mindThomas/STM32F0-MotorDriver/PCB/Rendering.png

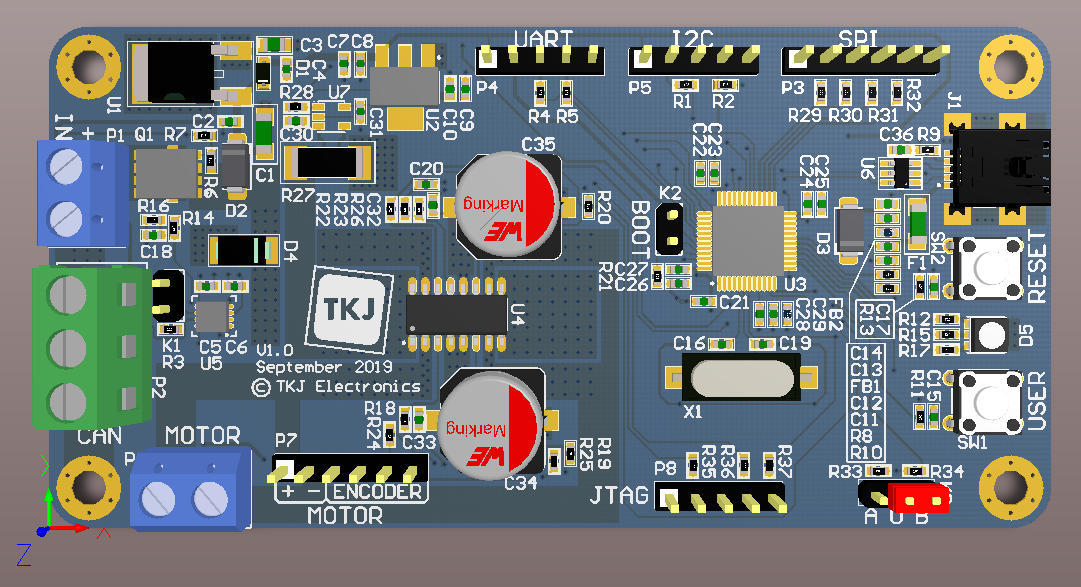
PCB/Rendering.png
