mindThomas/STM32F0-MotorDriver/README.md

# STM32F0-MotorDriver
Custom DC motor driver project (PCB+Firmware) with current control

## Cloning
Clone the repository recursively to download the included STM32 libraries
