mindThomas/STM32F0-MotorDriver/STM32 pinout overview.xlsx

STM32 pinout overview
Notes:
STM32F042C6T6
8 MHz HSE Oscillator
Device | Pin name | Pintype | I/O (set fra STM32) | Periphiral type | Assigned periphiral | STM32 Pin | Note | Extra Notes
Misc:
 | BTN | Digital | I | GPIO |  | PA4 | Active high, with debounce LPF
 | MASTER | Digital | I | GPIO |  | PB4 | Active high
 | SLAVE | Digital | I | GPIO |  | PB5 | Active high
LED:
 | Red | Digital | O | PWM | TIM3_CH3 | PB0 | 16-bit timer
 | Green | Digital | O | PWM | TIM3_CH2 | PA7 | 16-bit timer
 | Blue | Digital | O | PWM | TIM3_CH1 | PA6 | 16-bit timer
USB:
 | USB_DP | Digital | I/O | USB | USB_DP | PA12
 | USB_DM | Digital | I/O | USB | USB_DM | PA11
CAN:
 | CAN RX | Digital | I | CAN | CAN_RX | PB8
 | CAN TX | Digital | O | CAN | CAN_TX | PB9
 | CAN_STBY | Digital | O | GPIO |  | PA5
I2C:
 | SCL | Digital | I/O | I2C | I2C1_SCL | PB10
 | SDA | Digital | I/O | I2C | I2C1_SDA | PB11
UART:
 | TX | Digital | O | UART | USART1_TX | PB6
 | RX | Digital | I | UART | USART1_RX | PB7
SPI:
 | SCLK | Digital | O | SPI | SPI2_SCK | PB13
 | MISO | Digital | I | SPI | SPI2_MISO | PB14
 | MOSI | Digital | O | SPI | SPI2_MOSI | PB15
 | CS | Digital | O | SPI | SPI2_NSS | PB12
JTAG:
 | SWCLK | Digital | I | JTAG |  | PA14
 | SWDIO | Digital | I/O | JTAG |  | PA13
 | NRST | Digital | I | JTAG
Motor driver:
 | PWM | Digital | O | GPIO | TIM1_CH1 | PA8 | 16-bit timer
 | INA | Digital | O | GPIO | TIM1_CH2 | PA9 | 16-bit timer
 | INB | Digital | O | PWM | TIM1_CH3 | PA10 | 16-bit timer
 | SEL0 | Digital | O | GPIO |  | PA3 | Current sense selection according to Table 11. For current sense during operation pin should be set to the value as INA.
Encoder:
 | Encoder A | Digital | I | Quadrature Decoder | TIM2_CH1 | PA15 | 32-bit timer
 | Encoder B | Digital | I | Quadrature Decoder | TIM2_CH2 | PB3 | 32-bit timer
Sense:
 | CS | Analog | I | ADC | ADC_IN0 | PA0 | INA180 current sense | RC filter on INA Current Sense output of 10 KHz LPF
 | VNH_CS | Analog | I | ADC | ADC_IN1 | PA1 | VNH7070 high-side current sense output through a 681R sense resistor to ground | RC filter on VNH Current Sense output of 10 KHz LPF
 | VBAT | Analog | I | ADC | ADC_IN2 | PA2 | Voltage divider from VIN with 18.2 kOhm and 2.21 kOhm to ground | RC filter on VBAT measurement of 50-500 Hz LPF
 | VBUS_SENSE | Digital | I | GPIO | ADC_IN9 | PB1
