mindThomas/STM32F0-MotorDriver/Datasheets and Technical notes/TVS design recommendation (ESCON).png

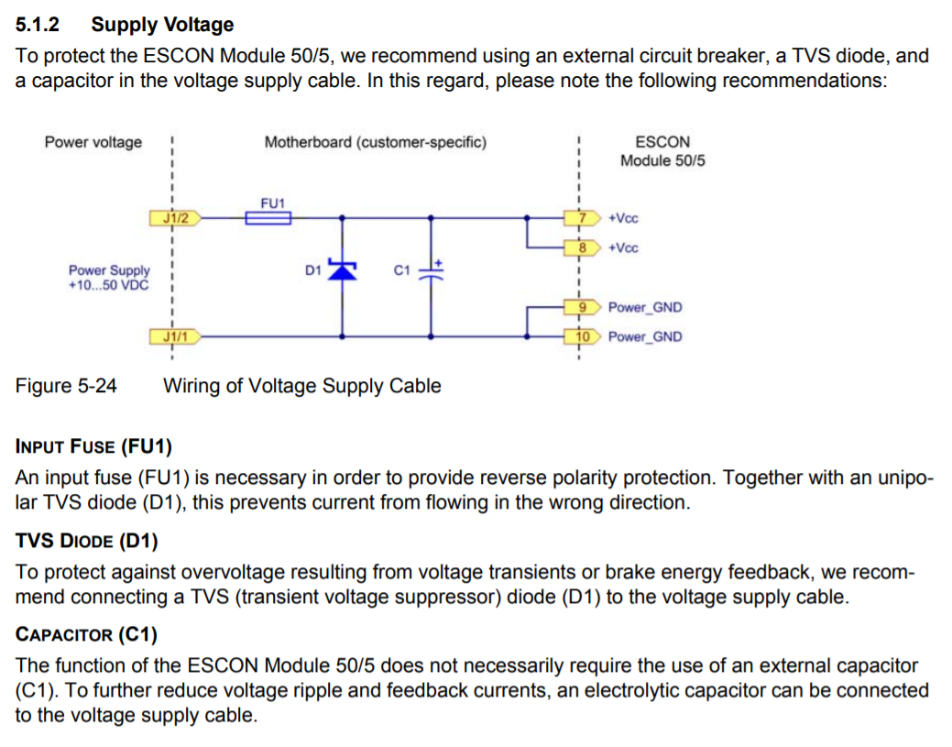
Datasheets and Technical notes/TVS design recommendation (ESCON).png
