mindThomas/STM32F0-MotorDriver/PCB/BOM_MotorDriverPCB_Detailed.xls

Sheet: BOM Report
Bill of Materials |  |  | <Parameter Title not found>
Source Data From: |  | MotorDriverPCB.PrjPCB
Project: |  | MotorDriverPCB.PrjPCB
Variant: |  | None
Creation Date: | 05-09-2019 | 00:21:36
Print Date: | 2019-09-16 | 23:00:03
Footprint | Comment | LibRef | Designator | Description |  | Manufacturer Part number | Digikey link | Quantity
1206C-GENERIC | 10uF, 50V | 1206C-10U-35V-X7R | C1 | GENERIC CAPACITOR NON POLARISED 1206 | Samsung Electro-Mechanics | CL31A106MBHNNNE | https://www.digikey.com/product-detail/en/samsung-electro-mechanics/CL31A106MBHNNNE/1276-6736-1-ND/5961595 | 1
0603C-GENERIC | 100nF | 0603C-100NF-25V-X7R-TDK | C2, C4, C5, C6, C8, C10, C13, C15, C17, C21, C22, C24, C26, C31, C32, C33, C36 | GENERIC CAPACITOR NON POLARISED 0603 | Samsung Electro-Mechanics | CL10B104KB8NNNC | https://www.digikey.com/product-detail/en/samsung-electro-mechanics/CL10B104KB8NNNC/1276-1000-1-ND/3889086 | 17
0805C-GENERIC | 10uF, 6.3V | 0805C-10UF-6V3-X5R-PAN | C3 | CAPACITOR 0805 CERAMIC | Samsung Electro-Mechanics | CL21A106KQCLRNC | https://www.digikey.com/product-detail/en/samsung-electro-mechanics/CL21A106KQCLRNC/1276-2405-1-ND/3890491 | 1
0603C-GENERIC | 1uF, 10V | 0603C-1UF-35V-X5R-TAY | C7, C9, C18, C29 | CAPACITOR 0603 CERAMIC | Samsung Electro-Mechanics | CL10A105MP8NNNC | https://www.digikey.com/product-detail/en/samsung-electro-mechanics/CL10A105MP8NNNC/1276-1866-1-ND/3889952 | 4
0603C-GENERIC | 4u7, 6.3V | 0603C-4U7-6V3-X5R-KEM | C11, C14, C23, C25, C27 | GENERIC CAPACITOR NON POLARISED 0603 | Samsung Electro-Mechanics | CL10A475KQ8NNNC | https://www.digikey.com/product-detail/en/samsung-electro-mechanics/CL10A475KQ8NNNC/1276-1045-1-ND/3889131 | 5
0603C-GENERIC | 10nF | 0603C-10NF-50V-X7R-MUR | C12, C20, C28, C30 | GENERIC CAPACITOR NON POLARISED 0603 | Walsin Technology Corporation | 0603B103K500CT | https://www.digikey.com/product-detail/en/walsin-technology-corporation/0603B103K500CT/1292-1386-1-ND/9355390 | 4
0603C-GENERIC | 18pF, NP0/COG 1% | 0603C-18PF-50V-C0G-MUR | C16, C19 | GENERIC CAPACITOR NON POLARISED 0603 | Walsin Technology Corporation | 0603N180J500CT | https://www.digikey.com/product-detail/en/walsin-technology-corporation/0603N180J500CT/1292-1494-1-ND/9355498 | 2
SMT_10x10.5 | 470uF, 35V | AluCap_SMT | C34, C35 | Surface mount, Polarized Electrolytic Aluminum Capacitor | Nichicon | UCL1V471MNL1GS | https://www.digikey.com/product-detail/en/nichicon/UCL1V471MNL1GS/493-3961-1-ND/2300388 | 2
SOD323 | DNP (NSR0530HT1G) | DIODE_SCHOTTKY | D1 | Diode Schottky | ON Semiconductor | NSR0530HT1G | https://www.digikey.com/product-detail/en/on-semiconductor/NSR0530HT1G/NSR0530HT1GOSCT-ND/5761654 | 1
DO-214AC-SMA | CDBA140-G | DIODE_SCHOTTKY | D2, D3 | Diode Schottky | Comchip Technology | CDBA140-G | https://www.digikey.com/product-detail/en/comchip-technology/CDBA140-G/641-1015-1-ND/1121137 | 2
DO-214AA | SMBJ26A | DIODE_TVS | D4 | Diode SMD Transil | Vishay Semiconductor Diodes Division | SMBJ26A-E3/52 | https://www.digikey.com/product-detail/en/vishay-semiconductor-diodes-division/SMBJ26A-E3-52/SMBJ26A-E3-52GICT-ND/2413391 | 1
LED-3535-6 | LED RGB Individual | LED RGB Individual | D5 | LED RGB Individual | Cree Inc. | CLX6F-FKC-CNP1ST1E1BB7D3D3 | https://www.digikey.com/product-detail/en/cree-inc/CLX6F-FKC-CNP1ST1E1BB7D3D3/CLX6F-FKC-CNP1ST1E1BB7D3D3CT-ND/6362814 | 1
1206C-GENERIC | 0ZCJ0035FF2G | FUSE-PTC | F1 | PTC Resettable Fuse | Bel Fuse Inc. | 0ZCJ0035FF2G | https://www.digikey.com/product-detail/en/bel-fuse-inc/0ZCJ0035FF2G/507-1800-1-ND/4156232 | 1
0603FB-GENERIC | BK1608TS102 | 0603FB-GENERIC | FB1, FB2 | FERRITE BEAD SMD | Taiyo Yuden | BK1608TS102-T | https://www.digikey.com/product-detail/en/taiyo-yuden/BK1608TS102-T/587-1895-1-ND/1465365 | 2
USB-MINI-B | USB Type B | USB-Type-B | J1 | Connector SMD-THD USB Type B middle mount | EDAC Inc. | 690-005-299-043 | https://www.digikey.com/product-detail/en/edac-inc/690-005-299-043/151-1206-1-ND/4312192 | 1
JMPR2 | JMPR2 | JMPR2 | K1, K2 | JMPR2 OPEN BY DEFAULT |  |  |  | 2
JMPR3-CLOSED-23 | JMPR3-23 | JMPR3-23 | K3 | JMPR3 |  |  |  | 1
SCREW-2-5mm | TB002-500-02BE | SCREW-2 | P1, P6 | Screw terminal, 2-pin, 5mm pitch | CUI Inc. | TB002-500-02BE | https://www.digikey.com/product-detail/en/cui-inc/TB002-500-02BE/102-6145-ND/10064069 | 2
SCREW-3-5mm | VI0301550000G | SCREW-3 | P2 | Screw terminal, 3-pin, 5mm pitch | Amphenol Anytek | VI0301550000G | https://www.digikey.com/product-detail/en/amphenol-anytek/VI0301550000G/609-3928-ND/2261293 | 1
HEADER-1X6 | Header 6 | Header 6 | P3, P7 | Header, 6-Pin |  |  |  | 2
HEADER-1X5 | UART1 | Header 5 | P4 | Header, 5-Pin |  |  |  | 1
HEADER-1X5 | I2C1 | Header 5 | P5 | Header, 5-Pin |  |  |  | 1
HEADER-1X5 | JTAG | Header 5 | P8 | Header, 5-Pin |  |  |  | 1
SO8FL-DFN5x6 | AONS21321 | MOSFET-P | Q1 | P-Channel MOSFET | Alpha & Omega Semiconductor Inc. | AONS21321 | https://www.digikey.com/product-detail/en/alpha-omega-semiconductor-inc/AONS21321/785-1800-1-ND/9974824 | 1
0603R-4K7 | 4K7 | 0603R-4K7 | R1, R2, R7, R8 | GENERIC RESISTOR 0603 | Stackpole Electronics Inc | RMCF0603FT4K70 | https://www.digikey.com/product-detail/en/stackpole-electronics-inc/RMCF0603FT4K70/RMCF0603FT4K70CT-ND/1943033 | 4
0603R-120 | 120R | 0603R-120 | R3 | GENERIC RESISTOR 0603 | Stackpole Electronics Inc | RMCF0603FT120R | https://www.digikey.com/product-detail/en/stackpole-electronics-inc/RMCF0603FT120R/RMCF0603FT120RCT-ND/1942967 | 1
0603R-1k | 1K | 0603R-1K | R4, R5, R18, R19, R20, R22, R24, R25, R29, R30, R31, R32 | GENERIC RESISTOR 0603 | Stackpole Electronics Inc | RMCF0603FT1K00 | https://www.digikey.com/product-detail/en/stackpole-electronics-inc/RMCF0603FT1K00/RMCF0603FT1K00CT-ND/1942996 | 12
0603R-10K | 10K | 0603R-10K | R6, R10, R11, R13, R21, R23, R28, R33, R34 | GENERIC RESISTOR 0603 | Stackpole Electronics Inc | RMCF0603FT10K0 | https://www.digikey.com/product-detail/en/stackpole-electronics-inc/RMCF0603FT10K0/RMCF0603FT10K0CT-ND/1943057 | 9
0603R-100K | 100K | 0603R-100K | R9 | GENERIC RESISTOR 0603 | Stackpole Electronics Inc | RMCF0603FT100K | https://www.digikey.com/product-detail/en/stackpole-electronics-inc/RMCF0603FT100K/RMCF0603FT100KCT-ND/1943118 | 1
0603R-82 | 82R | 0603R-82R | R12 | GENERIC RESISTOR 0603 | Stackpole Electronics Inc | RMCF0603FT82R0 | https://www.digikey.com/product-detail/en/stackpole-electronics-inc/RMCF0603FT82R0/RMCF0603FT82R0CT-ND/5049769 | 1
0603R-18K | 18.2K (1%) | 0603R-18K | R14 | GENERIC RESISTOR 0603 | Stackpole Electronics Inc | RMCF0603FT18K2 | https://www.digikey.com/product-detail/en/stackpole-electronics-inc/RMCF0603FT18K2/RMCF0603FT18K2CT-ND/1943073 | 1
0603R-56 | 56R | 0603R-56R | R15 | GENERIC RESISTOR 0603 | Stackpole Electronics Inc | RMCF0603FT56R0 | https://www.digikey.com/product-detail/en/stackpole-electronics-inc/RMCF0603FT56R0/RMCF0603FT56R0CT-ND/6053166 | 1
0603R-2K2 | 2.21K (1%) | 0603R-2K2 | R16 | GENERIC RESISTOR 0603 | Stackpole Electronics Inc | RMCF0603FT2K21 | https://www.digikey.com/product-detail/en/stackpole-electronics-inc/RMCF0603FT2K21/RMCF0603FT2K21CT-ND/1943012 | 1
0603R-27 | 27R | 0603R-27R | R17 | GENERIC RESISTOR 0603 | Stackpole Electronics Inc | RMCF0603FT27R0 | https://www.digikey.com/product-detail/en/stackpole-electronics-inc/RMCF0603FT27R0/RMCF0603FT27R0CT-ND/2418003 | 1
0603R-680 | 680R, 1% | 0603R-680 | R26 | GENERIC RESISTOR 0603 | Stackpole Electronics Inc | RMCF0603FT680R | https://www.digikey.com/product-detail/en/stackpole-electronics-inc/RMCF0603FT680R/RMCF0603FT680RCT-ND/6053170 | 1
2512R-GENERIC | 8 mOhm, 1%, 1W | 2512R | R27 | POWER RESISTOR 2512 | Panasonic Electronic Components | ERJ-M1WSF8M0U | https://www.digikey.com/product-detail/en/panasonic-electronic-components/ERJ-M1WSF8M0U/P8.0MCT-ND/300472 | 1
0603R-33 | 33R | 0603R-33 | R35, R36, R37 | GENERIC RESISTOR 0603 | Stackpole Electronics Inc | RMCF0603FT33R0 | https://www.digikey.com/product-detail/en/stackpole-electronics-inc/RMCF0603FT33R0/RMCF0603FT33R0CT-ND/1942950 | 3
TACT-TH-6x6 | 6X6_TACTILE | Tactile Switch | SW1, SW2 | Tactile Switch | TE Connectivity | 1825910-6 | https://www.digikey.com/product-detail/en/te-connectivity-alcoswitch-switches/1825910-6/450-1650-ND/1632536 | 2
DPAK | MC78M05CDTRKG | MC78M05CDTRKG | U1 | 5V, 500mA, LDO Regulator, 3-Pin DDPAK | ON Semiconductor | MC78M05CDTRKG | https://www.digikey.com/product-detail/en/on-semiconductor/MC78M05CDTRKG/MC78M05CDTRKGOSCT-ND/1139757 | 1
SOT-223 | AZ1117EH-3.3TRG1 | AZ1117EH-3.3TRG1 | U2 | 3.3V, 1A, LDO Regulator, 3-Pin SOT-223 | Diodes Incorporated | AZ1117EH-3.3TRG1 | https://www.digikey.com/product-detail/en/diodes-incorporated/AZ1117EH-3.3TRG1/AZ1117EH-3.3TRG1DICT-ND/5001336 | 1
STM-LQFP48_N | STM32F042C6T6 | STM32F042C6T6 | U3 | IC MCU 32BIT 32KB FLASH 48LQFP | STMicroelectronics | STM32F042C6T6TR | https://www.digikey.com/product-detail/en/stmicroelectronics/STM32F042C6T6TR/497-19319-1-ND/10063344 | 1
STM-SO-16N_M | VNH7070ASTR | VNH7070ASTR | U4 | SO 16 .15 TO JEDEC MS-012 | STMicroelectronics | VNH7070ASTR | https://www.digikey.com/product-detail/en/stmicroelectronics/VNH7070ASTR/497-17630-1-ND/7691023 | 1
VDFN8 | ATA6561 | ATA6561 | U5 | High-Speed CAN Transceiver with Standby Mode CAN FD Ready | Microchip Technology | ATA6561-GBQW-N | https://www.digikey.com/product-detail/en/microchip-technology/ATA6561-GBQW-N/ATA6561-GBQW-NCT-ND/9453176 | 1
SOT23-6 | USBLC6 | USBLC6 | U6 | Very low capacitance ESD protection | STMicroelectronics | USBLC6-2SC6 | https://www.digikey.com/product-detail/en/stmicroelectronics/USBLC6-2SC6/497-5235-1-ND/1121688 | 1
SOT23-5 | INA180A2 (50 V/V) | INA180A | U7 | INAx180 Low- and high-side voltage output, current-sense amplifiers | Texas Instruments | INA180A2IDBVT | https://www.digikey.com/product-detail/en/texas-instruments/INA180A2IDBVT/296-46628-1-ND/7219064 | 1
HC-49/US | 8MHz HC-49/US | HC-49/US | X1 | HC-49/US 8MHz, 18 pF, 30 ppm | Abracon LLC | ABLS-8.000MHZ-B-4-Y-T | https://www.digikey.com/product-detail/en/abracon-llc/ABLS-8.000MHZ-B-4-Y-T/535-14946-1-ND/9998023 | 1
 |  |  |  |  |  |  |  | 104
Approved |  | Notes

Sheet: Project Information
Project Full Path | C:\Users\Thomas\Dropbox\DC motor driver project\MotorDriverPCB.PrjPCB
Project Filename | MotorDriverPCB.PrjPCB
Variant Name | None
Data-Source Filename | MotorDriverPCB.PrjPCB
Data-Source Full Path | C:\Users\Thomas\Dropbox\DC motor driver project\MotorDriverPCB.PrjPCB
Title | <Parameter Title not found>
Total Quantity | 108
Report Time | 00:21:36
Report Date | 05-09-2019
Report Date & Tine | 05-09-2019 00:21:36
Output Name | Bill of Materials
Output Type | BOM_PartType
Output Generator Name | BOM
Output Generator Description | Bill of Materials
