mindThomas/STM32F0-MotorDriver/PCB/Schematic V1.0.pdf

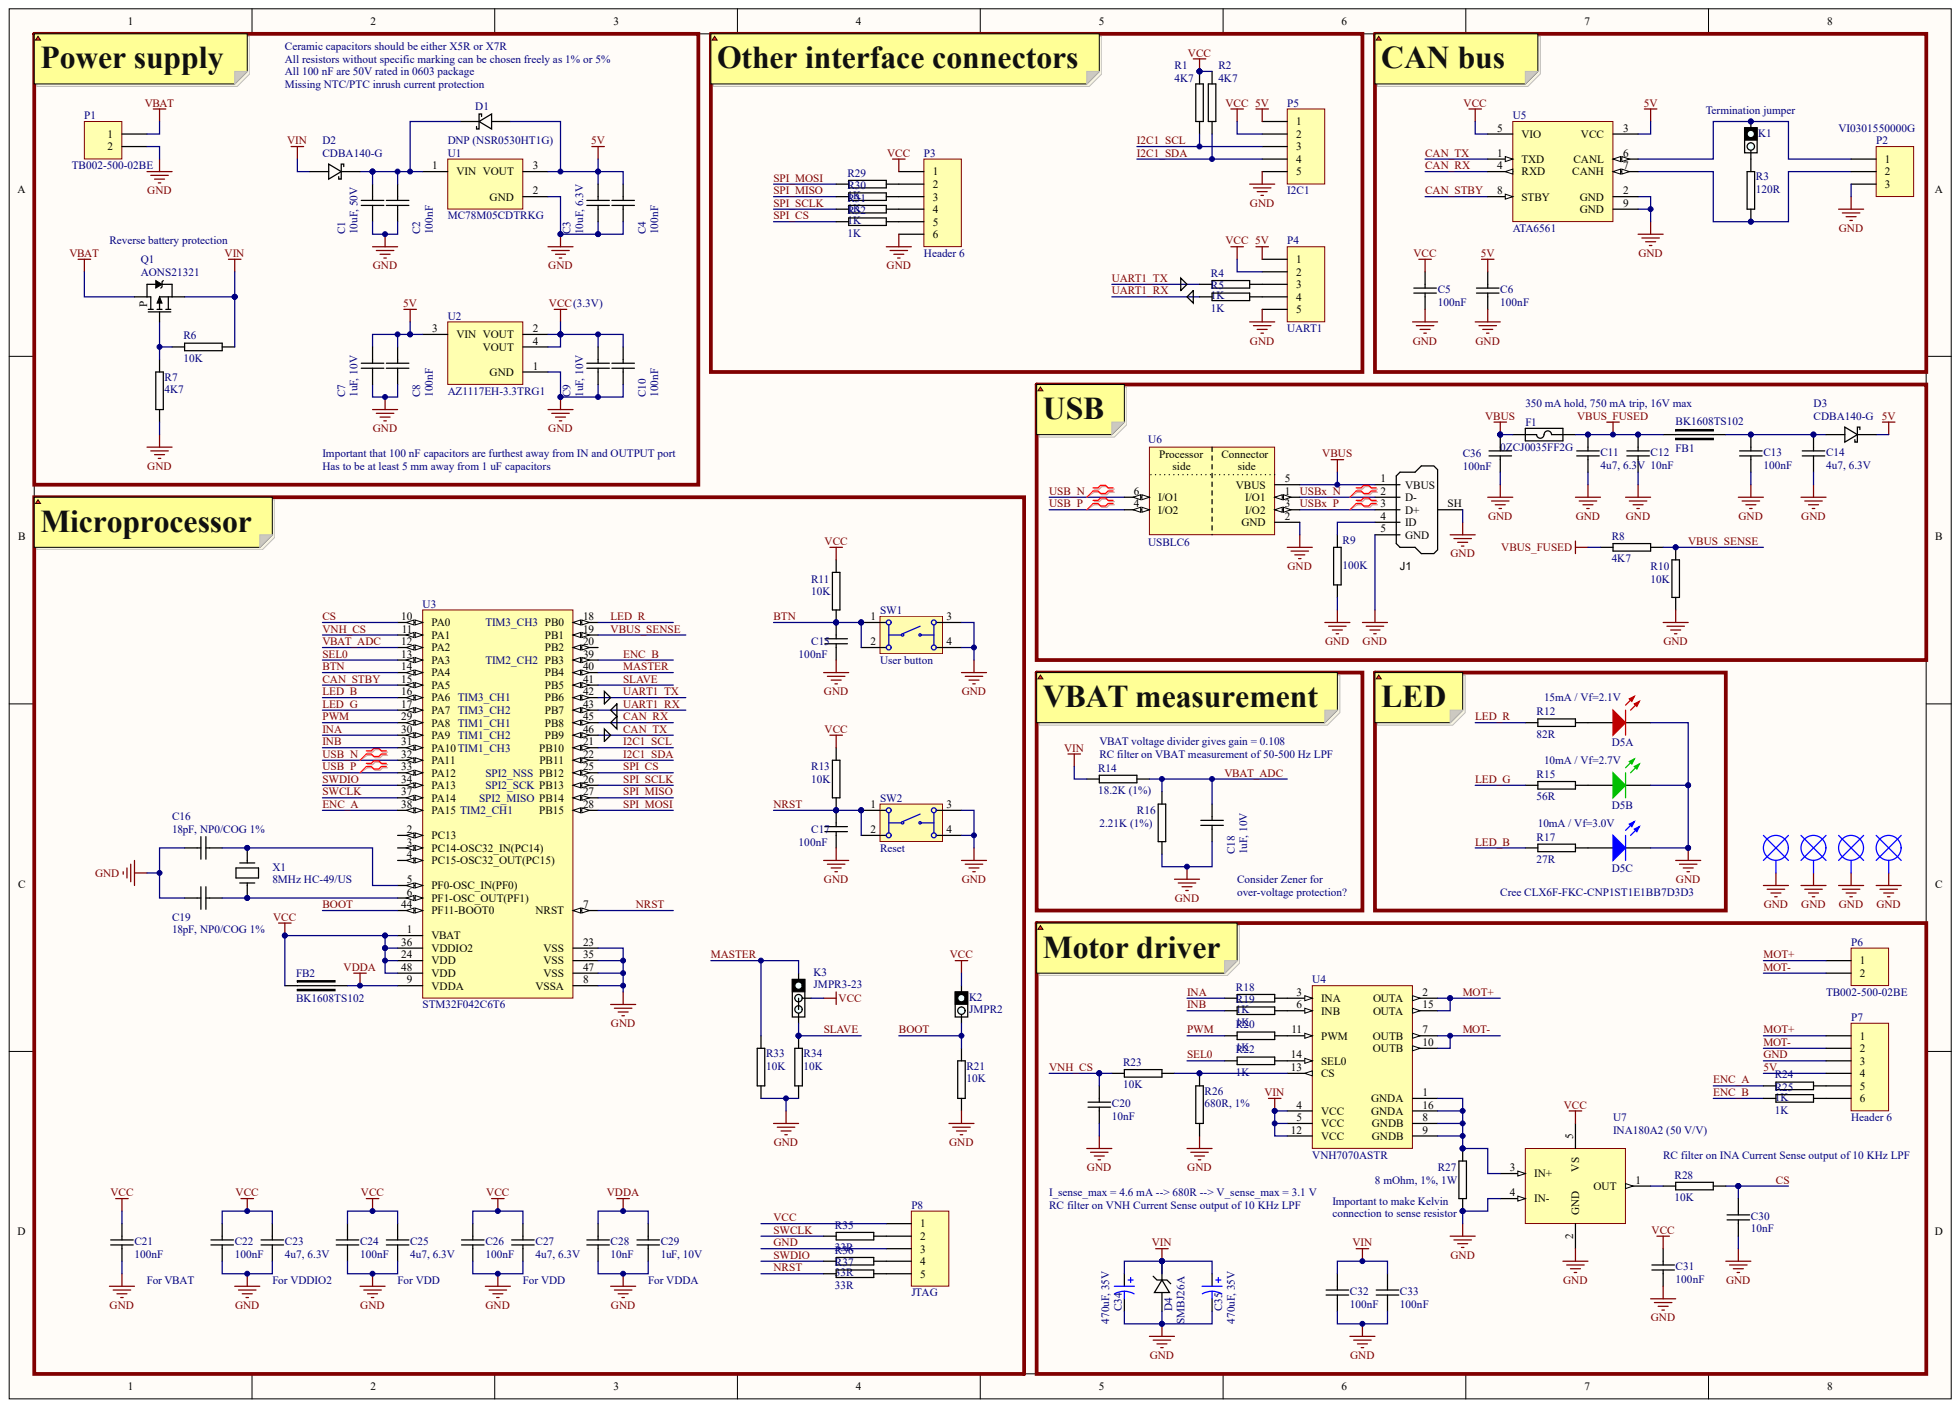
[picture p3: page 1]

Ceramic capacitors should be either X5R or X7R
All resistors without specific marking can be chosen freely as 1% or 5%
All 100 nF are 50V rated in 0603 package
Missing NTC/PTC inrush current protection

Important that 100 nF capacitors are furthest away from IN and OUTPUT port
Has to be at least 5 mm away from 1 uF capacitors

Processor side | Connector side

VBAT voltage divider gives gain = 0.108
RC filter on VBAT measurement of 50-500 Hz LPF

RC filter on INA Current Sense output of 10 KHz LPF

I_sense_max = 4.6 mA --> 680R --> V_sense_max = 3.1 V
RC filter on VNH Current Sense output of 10 KHz LPF

Important to make Kelvin
connection to sense resistor

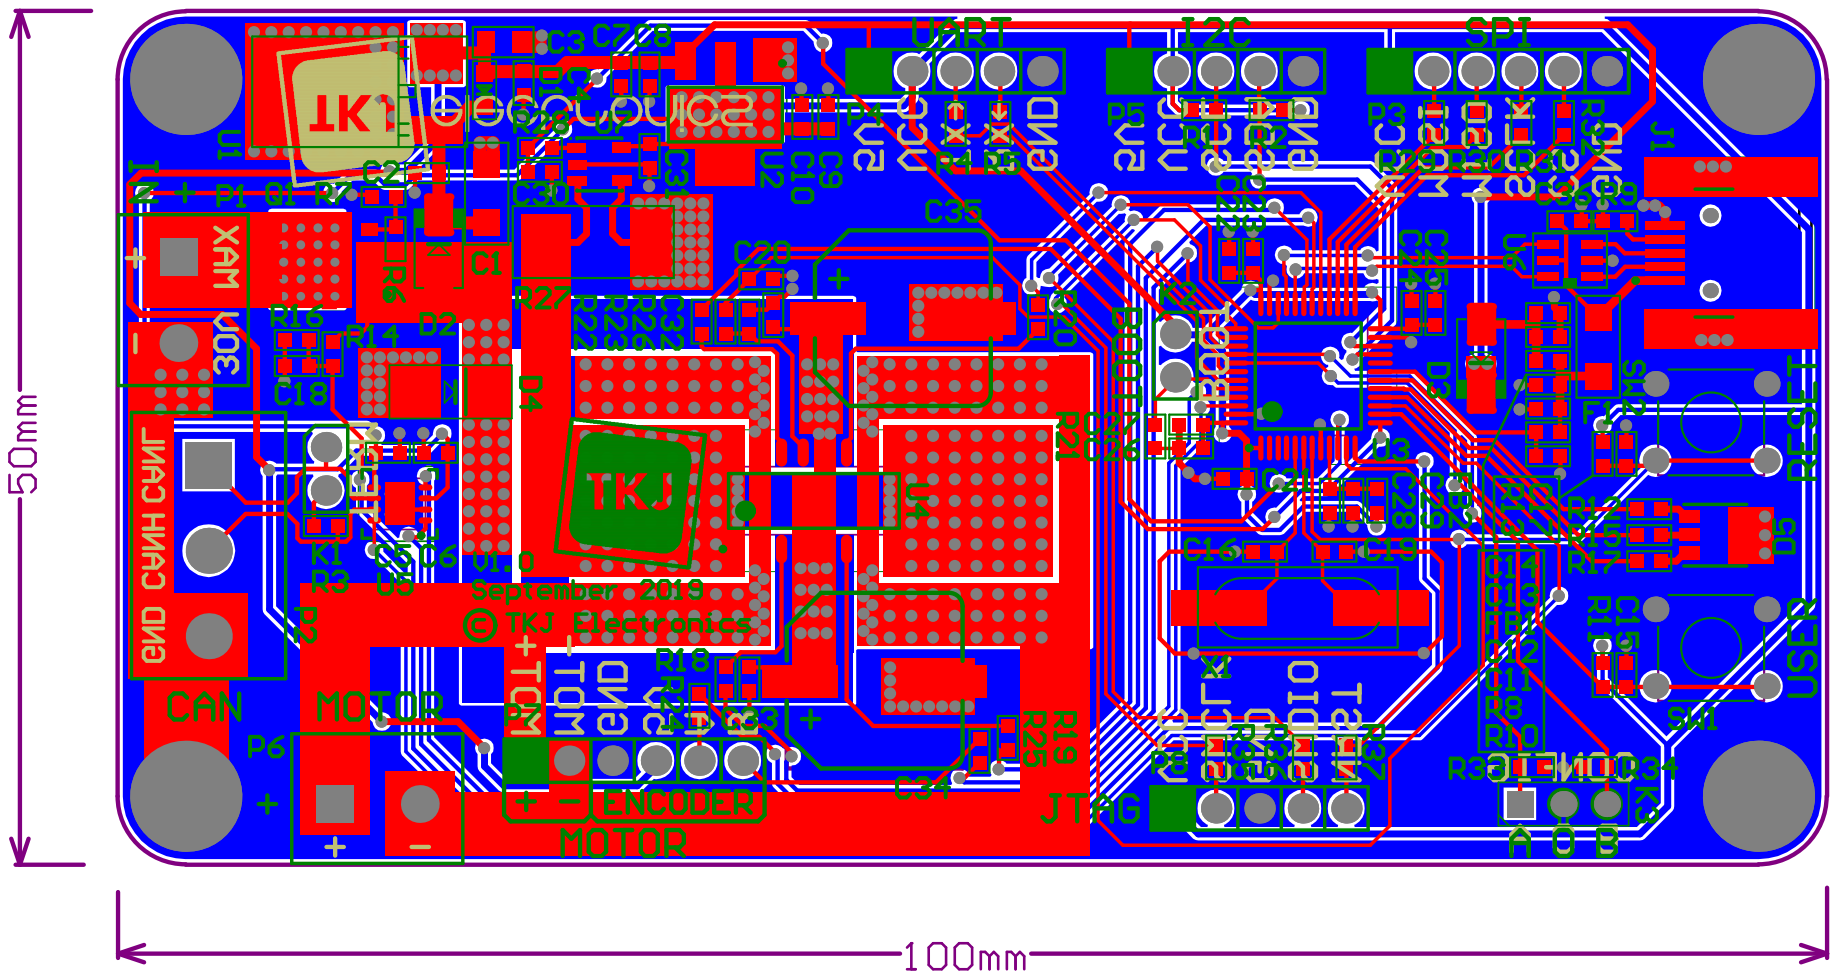
[picture p4: page 2]
