mindThomas/STM32F0-MotorDriver/(list of files, drawings)

Other design files:
PCB/Altium/Components.PcbLib
PCB/Altium/Components.SchLib
PCB/Altium/MotorDriverPCB.PcbDoc
PCB/Altium/MotorDriverPCB.PrjPCB
PCB/Altium/MotorDriverPCB.SchDoc
