mindThomas/STM32F0-MotorDriver/Firmware/MotorDriver-Firmware.ioc

Mcu.UserName=STM32F042C6Tx
PA0.Signal=ADC_IN0
PA1.Signal=ADC_IN1
PA10.Signal=S_TIM1_CH3
PA13.Signal=SYS_SWDIO
PA14.Signal=SYS_SWCLK
PA15.Signal=S_TIM2_CH1_ETR
PA2.Signal=ADC_IN2
PA3.Signal=GPIO_Output
PA4.Signal=GPIO_Output
PA5.Signal=GPIO_Output
PA6.Signal=S_TIM3_CH1
PA7.Signal=S_TIM3_CH2
PA8.Signal=S_TIM1_CH1
PA9.Signal=S_TIM1_CH2
PB0.Signal=S_TIM3_CH3
PB1.Signal=ADC_IN9
PB10.Signal=I2C1_SCL
PB11.Signal=I2C1_SDA
PB12.Signal=SPI2_NSS
PB13.Signal=SPI2_SCK
PB14.Signal=SPI2_MISO
PB15.Signal=SPI2_MOSI
PB3.Signal=S_TIM2_CH2
PB4.Signal=GPIO_Input
PB5.Signal=GPIO_Input
PB6.Signal=USART1_TX
PB7.Signal=USART1_RX
PF0-OSC_IN.Signal=RCC_OSC_IN
PF1-OSC_OUT.Signal=RCC_OSC_OUT
