mindThomas/STM32F0-MotorDriver/Firmware/Src/main.c

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

/* Includes ------------------------------------------------------------------*/
#include "main.h"

/* USER CODE BEGIN Includes */
#include "string.h" // for memset
/* USER CODE END Includes */


/* USER CODE BEGIN PV */
#define SAMPLE_COUNT 400
static _Bool recordSamples = 0;
static uint32_t time_low[SAMPLE_COUNT];
static uint32_t time_high[SAMPLE_COUNT];
//static uint32_t time_vin[2*SAMPLE_COUNT];
static int16_t sample_low[SAMPLE_COUNT];
static int16_t sample_high[SAMPLE_COUNT];
//static int16_t sample_vin[2*SAMPLE_COUNT];
static uint32_t sampleIndex_low = 0;
static uint32_t sampleIndex_high = 0;
//static uint32_t sampleIndex_vin = 0;

float vref = 0;
uint32_t vref_uint = 0;
const uint32_t VREF_SAMPLE_COUNT_FINISHED = 1000;
uint32_t vrefSampleCount = 10000;
uint16_t VrefVoltage = 0;
int32_t ADC_offset = 0;

_Bool ChannelAlternation = 0;
_Bool FirstTime = 1;
_Bool PWM_Level = 1;
uint16_t Duty1preload = 0, Duty2preload = 0;
uint16_t Duty1 = 0, Duty2 = 0;
/* USER CODE END PV */

void SystemClock_Config(void);
static void MX_GPIO_Init(void);
static void MX_I2C1_Init(void);
static void MX_USART1_UART_Init(void);
static void MX_SPI2_Init(void);
static void MX_TIM1_Init(void);
static void MX_ADC_Init(void);
static void MX_TIM2_Init(void);
static void MX_TIM3_Init(void);
/* USER CODE BEGIN PFP */
void SetTimerFrequencyAndDutyCycle(uint32_t freq, float dutyPct);
void BufferTransfer(uint8_t * buffer, uint16_t bytesToSend);
/* USER CODE END PFP */

/**
  * @brief  The application entry point.
  * @retval int
  */
int main(void)
{
  /* USER CODE BEGIN 1 */
  memset(time_low, 0, sizeof(time_low));
  memset(time_high, 0, sizeof(time_high));
  memset(sample_low, 0, sizeof(sample_low));
  memset(sample_high, 0, sizeof(sample_high));
  /* USER CODE END 1 */


  /* MCU Configuration--------------------------------------------------------*/

  /* Configure the system clock */
  SystemClock_Config();

  /* Reset of all peripherals, Initializes the Flash interface and the Systick. */
  HAL_Init();

  /* USER CODE BEGIN Init */
  LL_Init1msTick(48000000);   // enabling use of e.g. LL_SYSTICK_IsActiveCounterFlag()
  /* USER CODE END Init */

  /* Initialize all configured peripherals */
  MX_GPIO_Init();
  //MX_I2C1_Init();
  MX_USART1_UART_Init();
  MX_SPI2_Init();
  MX_TIM1_Init();
  MX_ADC_Init();
  MX_TIM2_Init();
  MX_TIM3_Init();
  /* USER CODE BEGIN 2 */

  // Initialize debug output pin
  LL_GPIO_InitTypeDef GPIO_InitStruct = {0};
  GPIO_InitStruct.Pin = LL_GPIO_PIN_10;
  GPIO_InitStruct.Mode = LL_GPIO_MODE_OUTPUT;
  GPIO_InitStruct.Speed = LL_GPIO_SPEED_FREQ_LOW;
  GPIO_InitStruct.OutputType = LL_GPIO_OUTPUT_PUSHPULL;
  GPIO_InitStruct.Pull = LL_GPIO_PULL_NO;
  LL_GPIO_Init(GPIOB, &GPIO_InitStruct);

  GPIOA->BSRR = GPIO_PIN_3; // SEL0 = High
  SetTimerFrequencyAndDutyCycle(1000, 0.5);
  LL_TIM_OC_SetCompareCH1(TIM1, 0); // PWM
  LL_TIM_OC_SetCompareCH2(TIM1, 0); // INA = High
  LL_TIM_OC_SetCompareCH3(TIM1, 0); // INB = Low

  // Enable all available PWM (output compare) outputs
  LL_TIM_EnableAllOutputs(TIM1);

  // Enable timer
  LL_TIM_EnableCounter(TIM1);

  // Enable channels
  LL_TIM_CC_EnableChannel(TIM1, LL_TIM_CHANNEL_CH1);
  LL_TIM_CC_EnableChannel(TIM1, LL_TIM_CHANNEL_CH2);
  LL_TIM_CC_EnableChannel(TIM1, LL_TIM_CHANNEL_CH3);
  LL_TIM_CC_EnableChannel(TIM1, LL_TIM_CHANNEL_CH4);

	HAL_Delay(2000); // wait for stabilization

	/*// Vref calibration: Take 1000 samples of Vref sampled at 1000 Hz
	vref_uint = 0;
	vrefSampleCount = 0; // sample offset
	while (vrefSampleCount < VREF_SAMPLE_COUNT_FINISHED)
		HAL_Delay(1);

	vref_uint = vref_uint / vrefSampleCount;
	vrefSampleCount = VREF_SAMPLE_COUNT_FINISHED + 1; // marks that offset computation has finished
	VrefVoltage = __LL_ADC_CALC_VREFANALOG_VOLTAGE(vref_uint, LL_ADC_RESOLUTION_12B);

	// Offset calibration: Take 1000 samples of VNH_CS sampled at 1000 Hz
	LL_ADC_REG_SetSequencerChannels(ADC1, LL_ADC_CHANNEL_1); // change to sample from channel 1 (VNH_CS)
	vref_uint = 0;
	vrefSampleCount = 0; // sample offset
	while (vrefSampleCount < VREF_SAMPLE_COUNT_FINISHED)
		HAL_Delay(1);

	vref_uint = vref_uint / vrefSampleCount;
	vrefSampleCount = VREF_SAMPLE_COUNT_FINISHED + 1; // marks that offset computation has finished
	ADC_offset = vref_uint;*/

	//LL_ADC_REG_SetSequencerChannels(ADC1, LL_ADC_CHANNEL_0); // change to sample from channel 0 (INA180_CS)
	LL_ADC_REG_SetSequencerChannels(ADC1, LL_ADC_CHANNEL_1); // change to sample from channel 1 (VNH_CS)
	HAL_Delay(1000); // wait for stabilization

	SetTimerFrequencyAndDutyCycle(20000, 0.5);

	/*recordSamples = 1;

	while (sampleIndex_low < SAMPLE_COUNT && sampleIndex_high < SAMPLE_COUNT)
		HAL_Delay(1);

	recordSamples = 0;*/

	recordSamples = 1;

  /* USER CODE END 2 */

  /* Infinite loop */
  /* USER CODE BEGIN WHILE */
  int8_t duty = 50;
  _Bool up = 1;
  while (1)
  {
    /* USER CODE END WHILE */
	  SetTimerFrequencyAndDutyCycle(20000, (float)duty / 100.0f);
	  HAL_Delay(30);
	  if (up)
		  duty += 1;
	  else
		  duty -= 1;

	  if (duty >= 100 || duty <= 0)
		  up = !up;
    /* USER CODE BEGIN 3 */
  }
  /* USER CODE END 3 */
}

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
/* USER CODE BEGIN 4 */
void SetTimerFrequencyAndDutyCycle(uint32_t freq, float dutyPct)
{
	const uint32_t PCLK = 48000000;
	const uint16_t PRESCALER = 23;
	const float ADC_SAMPLE_TIME_US = 4.5; // See MATLAB script: 'ADC_Configuration.m'
	const float HIGH_SAMPLE_OFFSET_US = 10;
	const float LOW_SAMPLE_OFFSET_US = 10;

	LL_TIM_SetPrescaler(TIM1, PRESCALER);

	uint32_t ARR = (PCLK / (uint32_t)(freq*(PRESCALER+1))) - 1;
	LL_TIM_SetAutoReload(TIM1, ARR);

	if (dutyPct < 0) dutyPct = 0.0;
	if (dutyPct > 1) dutyPct = 1.0;

	uint16_t END = ARR + 1;
	uint16_t CENTER = END * dutyPct;
	uint16_t HighOffsetDuty = (END*freq) / (1000000 / HIGH_SAMPLE_OFFSET_US);
	uint16_t LowOffsetDuty = (END*freq) / (1000000 / LOW_SAMPLE_OFFSET_US);
	uint16_t SampleTimeOffsetDuty = (END*freq) / (1000000 / ADC_SAMPLE_TIME_US);

	if (CENTER > (LOW_SAMPLE_OFFSET_US+SampleTimeOffsetDuty))
		Duty1preload = CENTER/2 - SampleTimeOffsetDuty;
	else
		Duty1preload = CENTER/2 + HIGH_SAMPLE_OFFSET_US;
	//Duty2preload = (END - CENTER) / 2 + CENTER - SampleDuty;
	//Duty1preload = CENTER - SampleDuty;
	//Duty2preload = END - SampleDuty;
	//Duty1preload = LowOffsetDuty;
	//Duty2preload = CENTER + HighOffsetDuty;

	LL_TIM_OC_SetCompareCH1(TIM1, CENTER); // PWM
	LL_TIM_OC_SetCompareCH2(TIM1, END); // INA = High
	LL_TIM_OC_SetCompareCH3(TIM1, 0); // INB = Low

	if (FirstTime) {
		Duty1 = Duty1preload;
		Duty2 = Duty2preload;
		LL_TIM_OC_SetCompareCH4(TIM1, Duty1); // Sample location
	}

	/*
    //__HAL_TIM_SET_COMPARE(&htim1, TIM_CHANNEL_5, CENTER - SampleDuty); // sample location
    //__HAL_TIM_SET_COMPARE(&htim1, TIM_CHANNEL_6, END - SampleDuty); // sample location
    __HAL_TIM_SET_COMPARE(&htim1, TIM_CHANNEL_5, CENTER/2 - SampleDuty); // sample location
    __HAL_TIM_SET_COMPARE(&htim1, TIM_CHANNEL_6, (END - CENTER) / 2 + CENTER - SampleDuty); // sample location

	__HAL_TIM_SET_COMPARE(&htim1, TIM_CHANNEL_1, 0);
	__HAL_TIM_SET_COMPARE(&htim1, TIM_CHANNEL_3, CENTER);
	*/
}

void BufferTransfer(uint8_t * buffer, uint16_t bytesToSend)
{
  uint16_t ubSend = 0;
  /* Send characters one per one, until last char to be sent */
  while (ubSend < bytesToSend)
  {
#if (USE_TIMEOUT == 1)
    Timeout = USART_SEND_TIMEOUT_TXE_MS;
#endif /* USE_TIMEOUT */

    /* Wait for TXE flag to be raised */
    while (!LL_USART_IsActiveFlag_TXE(USART1))
    {
#if (USE_TIMEOUT == 1)
      /* Check Systick counter flag to decrement the time-out value */
      if (LL_SYSTICK_IsActiveCounterFlag())
      {
        if(Timeout-- == 0)
        {
          /* Time-out occurred. Set LED to blinking mode */
          //LED_Blinking(LED_BLINK_SLOW);
        }
      }
#endif /* USE_TIMEOUT */
    }

    /* If last char to be sent, clear TC flag */
    if (ubSend == (bytesToSend - 1))
    {
      LL_USART_ClearFlag_TC(USART1);
    }

    /* Write character in Transmit Data register.
       TXE flag is cleared by writing data in TDR register */
    LL_USART_TransmitData8(USART1, buffer[ubSend++]);
  }

#if (USE_TIMEOUT == 1)
  Timeout = USART_SEND_TIMEOUT_TC_MS;
#endif /* USE_TIMEOUT */

  /* Wait for TC flag to be raised for last char */
  while (!LL_USART_IsActiveFlag_TC(USART1))
  {
#if (USE_TIMEOUT == 1)
    /* Check Systick counter flag to decrement the time-out value */
    if (LL_SYSTICK_IsActiveCounterFlag())
    {
      if(Timeout-- == 0)
      {
        /* Time-out occurred. Set LED to blinking mode */
        //LED_Blinking(LED_BLINK_SLOW);
      }
    }
#endif /* USE_TIMEOUT */
  }
}

void TIM1_BRK_UP_TRG_COM_IRQHandler(void)
{
  /* Check whether CC1 interrupt is pending */
  if(LL_TIM_IsActiveFlag_TRIG(TIM1) == 1)
  {
    /* Clear the update interrupt flag*/
    LL_TIM_ClearFlag_TRIG(TIM1);

    // Toggle debug pin
    GPIOB->ODR ^= GPIO_PIN_10;
  }
}

uint32_t _frequency = 100;
void ADC1_IRQHandler(void)
{
  /* Check whether ADC group regular end of unitary conversion caused         */
  /* the ADC interruption.                                                    */
  if(LL_ADC_IsActiveFlag_EOC(ADC1) != 0)
  {
    /* Clear flag ADC group regular end of unitary conversion */
    LL_ADC_ClearFlag_EOC(ADC1);

    // Toggle debug pin
    GPIOB->ODR ^= GPIO_PIN_10;

    if (vrefSampleCount < VREF_SAMPLE_COUNT_FINISHED) {
		vref_uint += LL_ADC_REG_ReadConversionData12(ADC1);
		vrefSampleCount++;
	}
	if (recordSamples) {
		int32_t sample = (int32_t)LL_ADC_REG_ReadConversionData12(ADC1) - ADC_offset;
		if (PWM_Level == 1) { // sampling at the transition from Low to High == Low value sampling
			if (sampleIndex_low < SAMPLE_COUNT) {
				time_low[sampleIndex_low] = HAL_GetHighResTick();
				sample_low[sampleIndex_low] = sample;
				sampleIndex_low++;
			}
		} else {
			if (sampleIndex_high < SAMPLE_COUNT) {
				time_high[sampleIndex_high] = HAL_GetHighResTick();
				sample_high[sampleIndex_high] = sample;
				sampleIndex_high++;
			}
		}
	}

#if 0
    // Update Duty cycle to enable sampling on both low-to-high and high-to-low edge
    if (PWM_Level) {
    	LL_TIM_OC_SetCompareCH4(TIM1, Duty2);
    } else {
    	/*if (recordSamples) {
    		SetTimerFrequencyAndDutyCycle(_frequency, 0.5);
			_frequency += 5;
    	}*/

    	/*
    	if (ChannelAlternation == 0)
    			LL_ADC_REG_SetSequencerChannels(ADC1, LL_ADC_CHANNEL_1);
    		else
    			LL_ADC_REG_SetSequencerChannels(ADC1, LL_ADC_CHANNEL_0);
    		ChannelAlternation = !ChannelAlternation;
    	}
    	*/

    	Duty1 = Duty1preload;
    	Duty2 = Duty2preload;
    	LL_TIM_OC_SetCompareCH4(TIM1, Duty1);
    }
    PWM_Level = !PWM_Level;
#endif
  }
}
/* USER CODE END 4 */

/**
  * @brief  Period elapsed callback in non blocking mode
  * @note   This function is called  when TIM16 interrupt took place, inside
  * HAL_TIM_IRQHandler(). It makes a direct call to HAL_IncTick() to increment
  * a global variable "uwTick" used as application time base.
  * @param  htim : TIM handle
  * @retval None
  */
void HAL_TIM_PeriodElapsedCallback(TIM_HandleTypeDef *htim)
{
  if (htim->Instance == TIM16) {
    HAL_IncTick();
  }
}

/**
  * @brief  This function is executed in case of error occurrence.
  * @retval None
  */
void Error_Handler(void)
{
  /* USER CODE BEGIN Error_Handler_Debug */
  /* User can add his own implementation to report the HAL error return state */

  /* USER CODE END Error_Handler_Debug */
}

#ifdef  USE_FULL_ASSERT
/**
  * @brief  Reports the name of the source file and the source line number
  *         where the assert_param error has occurred.
  * @param  file: pointer to the source file name
  * @param  line: assert_param error line source number
  * @retval None
  */
void assert_failed(char *file, uint32_t line)
{
  /* USER CODE BEGIN 6 */
  /* User can add his own implementation to report the file name and line number,
     tex: printf("Wrong parameters value: file %s on line %d\r\n", file, line) */
  /* USER CODE END 6 */
}
#endif /* USE_FULL_ASSERT */

/************************ (C) COPYRIGHT STMicroelectronics *****END OF FILE****/
