mindThomas/STM32F0-MotorDriver/Firmware-Bringup/Inc/Priorities.h

/* Copyright (C) 2018-2019 Thomas Jespersen, TKJ Electronics. All rights reserved.
 *
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
 * Contact information
 * ------------------------------------------
 * Thomas Jespersen, TKJ Electronics
 * Web      :  http://www.tkjelectronics.dk
 * e-mail   :  thomasj@tkjelectronics.dk
 * ------------------------------------------
 */
 
#ifndef PRIORITIES_H
#define PRIORITIES_H

/* Define hardware interrupt priorities   (HAL_NVIC_SetPriority)
 * Lower value means higher priority
 * Interrupt priority has to be between 0 and 15
 * Remember to respect the "configLIBRARY_MAX_SYSCALL_INTERRUPT_PRIORITY" in FreeRTOSConfig.h, hence no hardware interrupt calling FreeRTOS functions must have a priority value lower than configLIBRARY_MAX_SYSCALL_INTERRUPT_PRIORITY
 */
#define HIGH_RES_TIMER_TICK_PRIORITY	0		// This timer is also used to generate ticks for any ST HAL library (eg. HAL_Delay)
#define ENCODER_TIMER_OVERFLOW_PRIORITY	1
#define ADC_DMA_INTERRUPT_PRIORITY		15

// Below are periphiral priorities which uses FreeRTOS functions
#define USB_INTERRUPT_PRIORITY		5
#define UART_INTERRUPT_PRIORITY		6
#define CAN_INTERRUPT_PRIORITY		7
#define SPI_INTERRUPT_PRIORITY		8
#define I2C_INTERRUPT_PRIORITY		9
#define TIMER_INTERRUPT_PRIORITY	10
#define IO_INTERRUPT_PRIORITY		11
#define SMBUS_INTERRUPT_PRIORITY	12


/* Define task priorities in FreeRTOS format
 * Higher values means higher priority
 * Hence low values denote low priority tasks. The idle task has priority 0 (tskIDLE_PRIORITY)
 * Task priority has to be between 0 and (configMAX_PRIORITIES-1)
 */
#define MAIN_TASK_PRIORITY				0
#define APPLICATION_TEMPLATE_PRIORITY	0
#define POWER_MANAGEMENT_PRIORITY		1
#define FRONT_PANEL_PRIORITY			2
#define TEST_BENCH_PRIORITY				3
#define DEBUG_MESSAGE_PRIORITY			4
#define BALANCE_CONTROLLER_PRIORITY		6
#define CURRENT_CONTROLLER_PRIORITY		8
#define CAN_RECEIVER_PRIORITY			9
#define UART_RECEIVER_PRIORITY			10
#define LSPC_RECEIVER_PRIORITY			11
#define USBCDC_TRANSMITTER_PRIORITY		12
#define LSPC_TRANSMITTER_PRIORITY		13  // important that this has the highest priority



#endif
