mindThomas/STM32F0-MotorDriver/(commit log)

2019-11-03 Added initial project files supporting Current sense sampling
    [STM32 pinout overview.xlsx]
2021-04-24 Open Sourcing of DC Motor driver project
2021-04-24 Added PCB design + Restructured into Monolithic repository
    [BOM_MotorDriverPCB_Detailed.xls, BOM_MotorDriverPCB_Simplified.xlsx, Components.PcbLib, Components.SchLib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]
